ipatiris/IRrepeater/esp8266-repeater-BOM_JLCSMT.xlsx

Comment | Designator | Footprint | JLCPCB Part #（optional）
1uF | C1 | C0603 | C15849
100uF | C2 | CASE-B_3528 | C16133
1uF | C3 | C0603 | C15849
1uF | C4 | C0603 | C15849
1uF | C5 | C0603 | C15849
100nF | C6 | C0805 | C49678
10uF | C8 | C0603 | C19702
10uF | C9 | C0603 | C19702
CHRG LED | CHRG | LED_0805 | C84256
DIODE | D1 | SOD-123 | C8598
DIODE | D2 | SOD-123 | C8598
DIODE | D3 | SOD-123 | C8598
DIODE | D4 | SOD-123 | C8598
GPIO12 LED | GPIO12 | LED_0805 | C84256
IR TRANS | Q2 | SOT-23-3 | C2150
12K | R1 | R0603 | C22790
12K | R2 | R0603 | C22790
12K | R3 | R0603 | C22790
12K | R4 | R0603 | C22790
12K | R5 | R0603 | C22790
1K | R6 | R0603 | C21190
0Ohms | R7 | R0603 | C21189
0Ohms | R8 | R0603 | C21189
5.1K | R9 | R0603 | C25197
1K | R10 | R0603 | C21190
5.1K | R11 | R0603 | C25197
75K | R12 | R0603 | C23242
22K | R13 | R0603 | C31850
100K | R14 | R0603 | C25803
1K | R15 | R0603 | C21190
5.1K | R16 | R0603 | C25197
100Ohms | R17 | R0603 | C22775
1K | R18 | R0603 | C21190
2K | R19 | R0603 | C22975
2K | R20 | R0603 | C22975
2K | R21 | R0603 | C22975
3.9K | R22 | R0603 | C23018
0Ohms | R23 | R0603 | C21189
READY LED | READY | LED_0805 | C2297
CHARGER IC | TP4056 | ESOP-8_EP_3.9x4.9x1.27P | C16581
USB C | U$1 | SMD | C393939
CH340G | U$3 | SOIC-16_3.9x9.9x1.27P | C14267
ESP8266 | U1 | DFN-22_16.0x24.0x2.0P | C82891
ME6211 | U2 | SOT-23-5 | C82942
