ipatiris/IRrepeater/Esp12e_IR_repeater.pdf

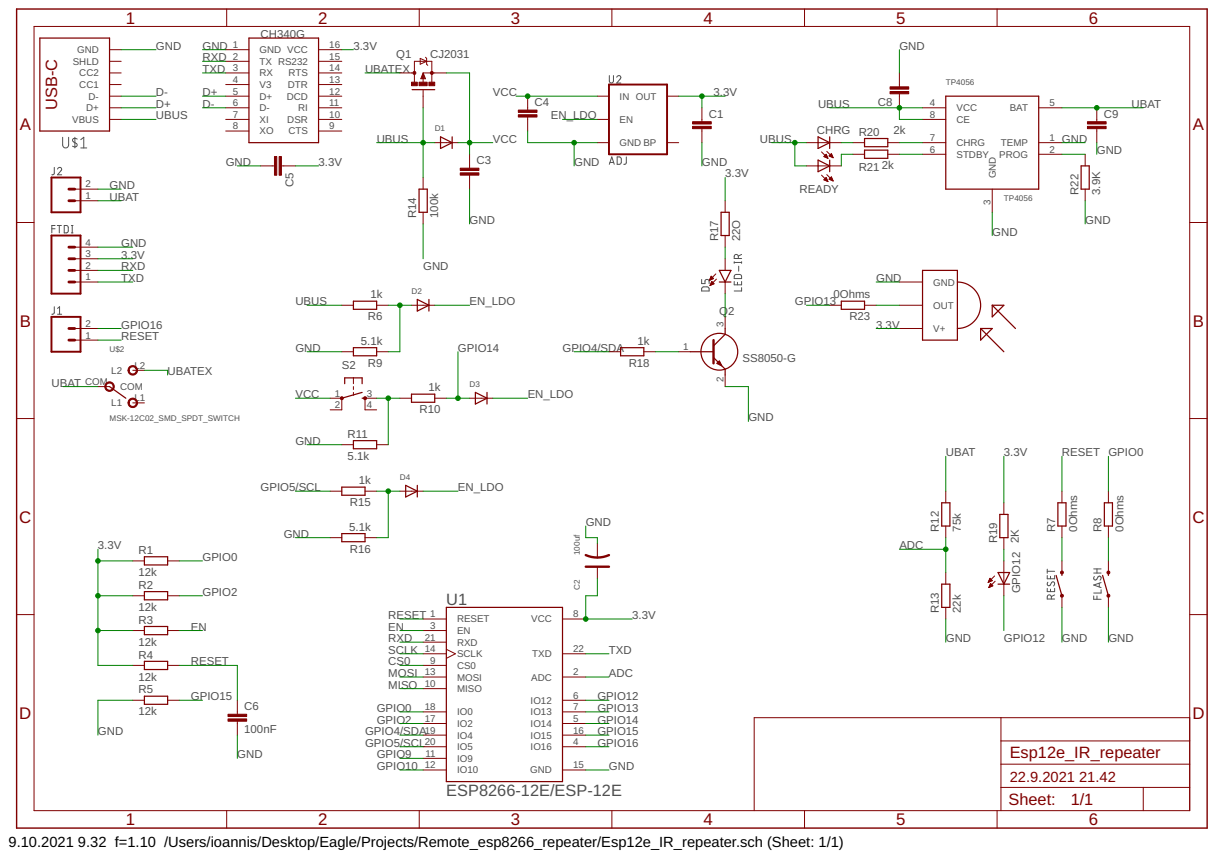
[picture p1: page 1]

9.10.2021 9.32 f=1.10 /Users/ioannis/Desktop/Eagle/Projects/Remote_esp8266_repeater/Esp12e_IR_repeater.sch (Sheet: 1/1)
