ipatiris/IRrepeater/Esp12e_IR_repeater.brd

## EAGLE design Esp12e_IR_repeater.brd (2021-10-09)

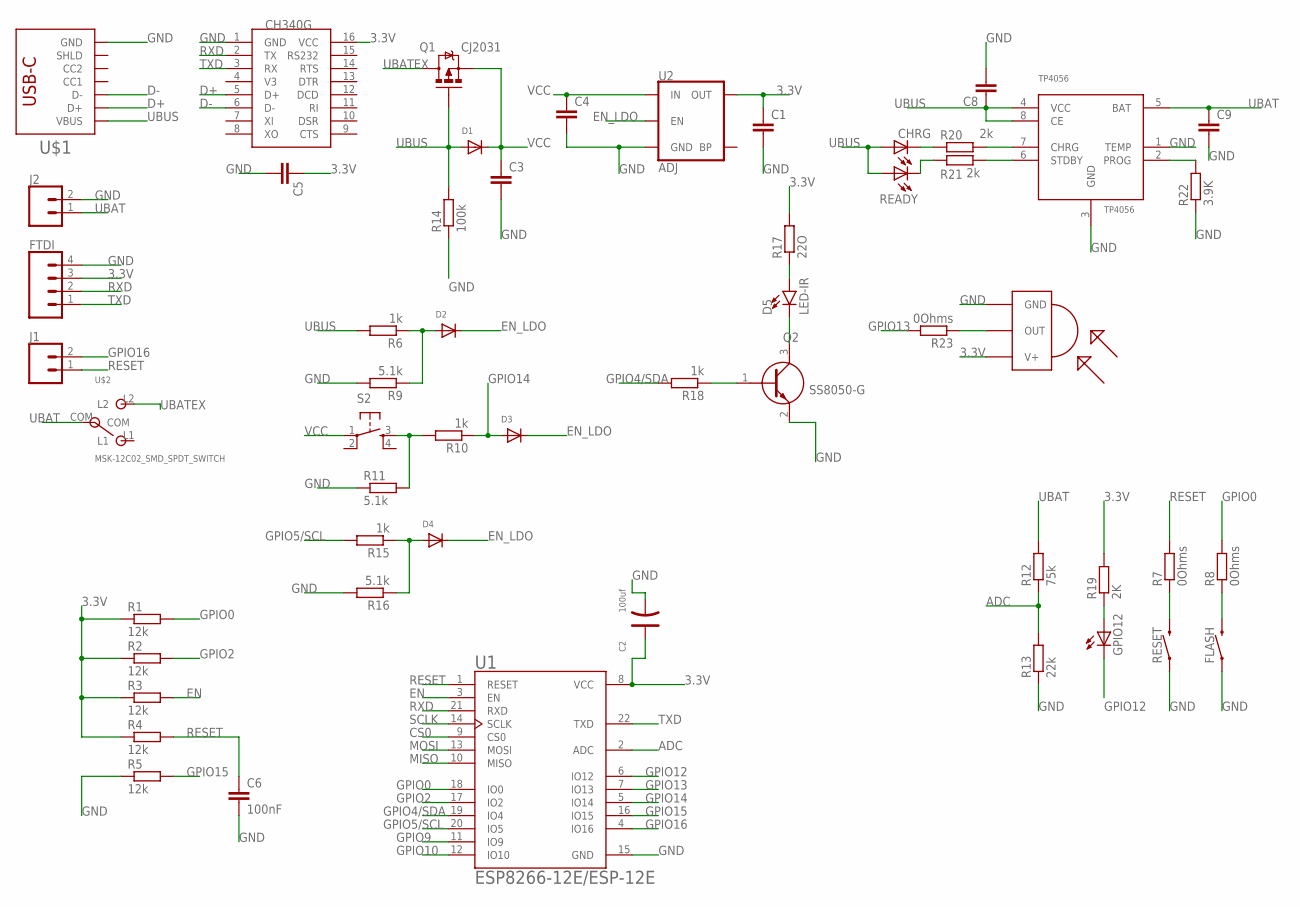
[picture p2: schematic Esp12e_IR_repeater.sch]

Parts:
C1, C3, C4, C5: 1uF; CAPC1608X85
C2: 100uf; AVX-B
C6: 100nF; C0805
C8, C9: 10uF; CAPC1608X85
CHRG: LEDCHIPLED_0805; CHIPLED_0805
D1, D2, D3, D4: DIODESOD-123; SOD-123
D5: LED-IR; LED_5MM
FLASH: RS032G05A3SM-SPST-MOMENTARY-SWSMD-1101NE; TACTILE-SWITCH-1101NE
FTDI: CONN_04; 1X04
GPIO12: LEDCHIPLED_0805; CHIPLED_0805
J1: CONN_02; 1X02
J2: CONN_02-JST-2-PTH-NO_SILK; JST-2-PTH-NS
Q1: CJ2031; SOT23-3
Q2: SS8050-G; SOT95P240X115-3N
R1, R2, R3, R4, R5: 12k; R0603
R6, R10, R15, R18: 1k; R0603
R7, R8, R23: 0Ohms; R0603
R9, R11, R16: 5.1k; R0603
R12: 75k; R0603
R13: 22k; R0603
R14: 100k; R0603
R17: 22O; R0603
R19: 2K; R0603
R20, R21: 2k; R0603
R22: 3.9K; R0603
READY: LEDCHIPLED_0805; CHIPLED_0805
RESET: RS032G05A3SM-SPST-MOMENTARY-SWSMD-1101NE; TACTILE-SWITCH-1101NE
S2: SWITCH-TACT_DTSM-6
TP4056: TP4056; SOP-8
U1: ESP8266-12E/ESP-12E; XCVR_ESP8266-12E/ESP-12E
U2: ADJ; SOT23-5
U$1: MOEKOE_USB_C_C393939; MOEKOE_USBC_C393939
U$2: MSK-12C02_SMD_SPDT_SWITCH; MSK-12C02
U$3: CH340G; SOIC16
U$4: TSOP1738; TSOP17XX

Connections:
3.3V: C1.1, C2.+, C5.1, FTDI.3, R1.1, R2.1, R3.1, R4.1, R17.2, R19.2, U1.8 (VCC), U2.5 (OUT), U$3.16 (VCC), U$4.V+
ADC: R12.1, R13.2, U1.2 (ADC)
CS0: U1.9 (CS0)
D+: U$1.A6 (D+), U$1.B6 (D+), U$3.5 (D+)
D-: U$1.A7 (D-), U$1.B7 (D-), U$3.6 (D-)
EN: R3.2, U1.3 (EN)
EN_LDO: D2.C, D3.C, D4.C, U2.3 (EN)
GND: C1.2, C2.-, C3.2, C4.2, C5.2, C6.2, C8.2, C9.2, FLASH.1, FTDI.4, J2.2, Q2.2 (E), R5.1, R9.2, R11.1, R13.1, R14.1, R16.2, R22.1, RESET.1, TP4056.1 (TEMP), TP4056.3 (GND), U1.15 (GND), U2.2 (GND), U$1.A1B12 (GND), U$1.B1A12 (GND), U$3.1 (GND), U$4.GND
GPIO0: R1.2, R8.2, U1.18 (IO0)
GPIO2: R2.2, U1.17 (IO2)
GPIO4/SDA: R18.2, U1.19 (IO4)
GPIO5/SCL: R15.2, U1.20 (IO5)
GPIO9: U1.11 (IO9)
GPIO10: U1.12 (IO10)
GPIO12: GPIO12.C, U1.6 (IO12)
GPIO13: R23.2, U1.7 (IO13)
GPIO14: D3.A, R10.1, U1.5 (IO14)
GPIO15: R5.2, U1.16 (IO15)
GPIO16: J1.2, U1.4 (IO16)
MISO: U1.10 (MISO)
MOSI: U1.13 (MOSI)
unnamed: FLASH.2, R8.1
unnamed: R7.1, RESET.2
unnamed: D2.A, R6.1, R9.1
unnamed: D4.A, R15.1, R16.1
unnamed: R20.2, TP4056.7 (CHRG)
unnamed: R10.2, R11.2, S2.3
unnamed: D5.A, R17.1
unnamed: D5.K (C), Q2.3 (C)
unnamed: Q2.1 (B), R18.1
unnamed: GPIO12.A, R19.1
unnamed: R21.2, TP4056.6 (STDBY)
unnamed: CHRG.C, R20.1
unnamed: R21.1, READY.C
unnamed: R22.2, TP4056.2 (PROG)
unnamed: R23.1, U$4.OUT
RESET: C6.1, J1.1, R4.2, R7.2, U1.1 (RESET)
RXD: FTDI.2, U1.21 (RXD), U$3.2 (TX)
SCLK: U1.14 (SCLK)
TXD: FTDI.1, U1.22 (TXD), U$3.3 (RX)
UBAT: C9.1, J2.1, R12.2, TP4056.5 (BAT), U$2.COM
UBATEX: Q1.3 (D), U$2.L2
UBUS: C8.1, CHRG.A, D1.A, Q1.1 (G), R6.2, R14.2, READY.A, TP4056.4 (VCC), TP4056.8 (CE), U$1.A4B9 (VBUS), U$1.B4A9 (VBUS)
VCC: C3.1, C4.1, D1.C, Q1.2 (S), S2.1, U2.1 (IN)

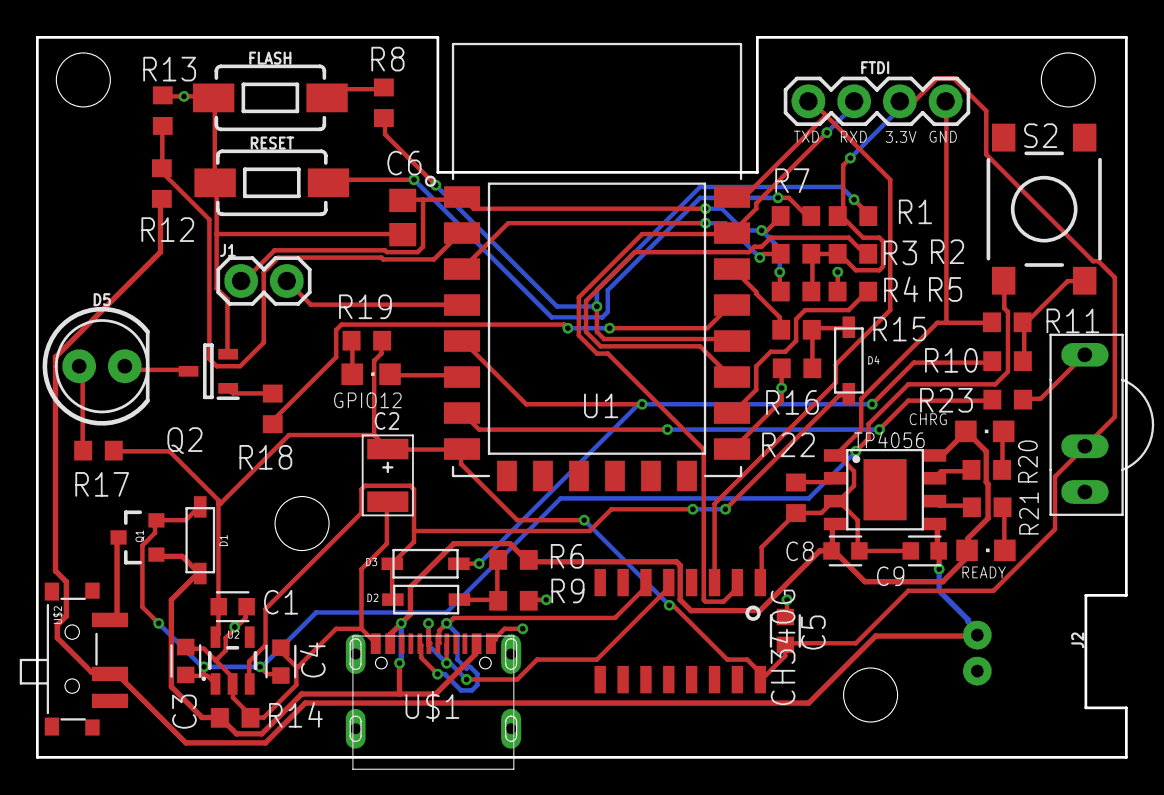
[picture p3: board Esp12e_IR_repeater.brd from above]

Board: 2 copper layers, 60.5 x 40.0 mm, 54 parts (0 on the bottom side), 38 nets.
